VinnieT1/zbook/zbook.step

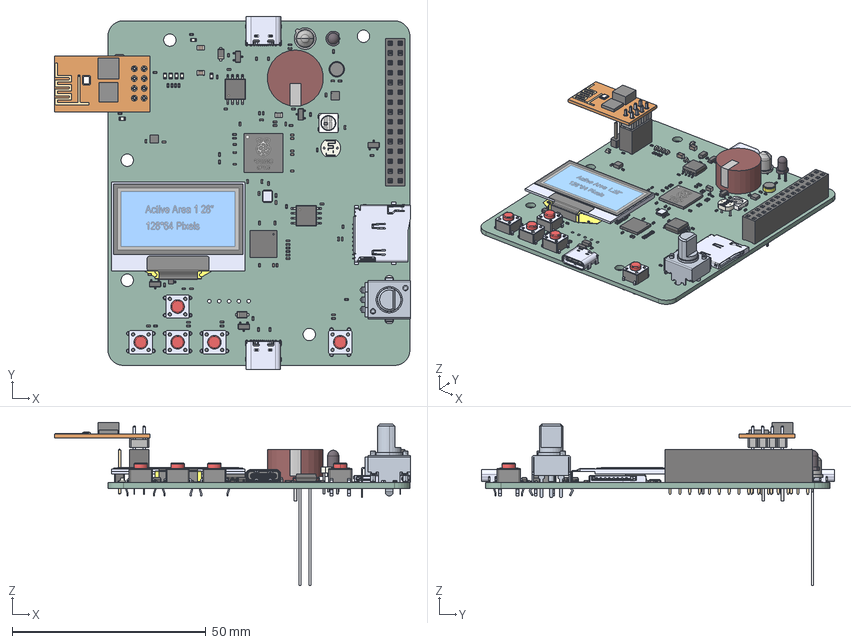
[picture p1: CAD file, 2026-01-20]
zbook.step
92.0 x 91.1 x 42.2 mm
ABM8-272-T3 x 2
R_0402_1005Metric x 46
C_0402_1005Metric x 53
SOT-23 x 6
QFN-56-1EP_7x7mm_P0.4mm_EP3.2x3.2mm
D_SOD-123F x 2
PinSocket_2x04_P2.54mm_Vertical
ESP-01
PS1440P02BT_TDK
SOIC-8_5.3x5.3mm_P1.27mm x 2
FZ2812-5050
LED_0603_1608Metric x 7
ptv09a-4x15f-xxxx
GSDA213
PinHeader_1x05_P2.54mm_Vertical
PinSocket_2x15_P2.54mm_Vertical
OP598A
User Library-RP2350B
C_0805_2012Metric x 2
L_0805_2012Metric
LED_D3.0mm_IRBlack
UJ20-C-H-G-SMT-1-P16-TR_UJ20-C-H-G-SMT-1-P16-TR x 2
DISPLAY_OLED_1.28 v3 v1
R_LDR_5.1x4.3mm_P3.4mm_Vertical
MSD-4-A
LTR-329ALS-01_LTO
Same_Sky_CMEJ-0415-42-P
zbook_PCB
