VinnieT1/zbook/zbook.kicad_pcb

## KiCad design zbook.kicad_pcb (2026-02-26)

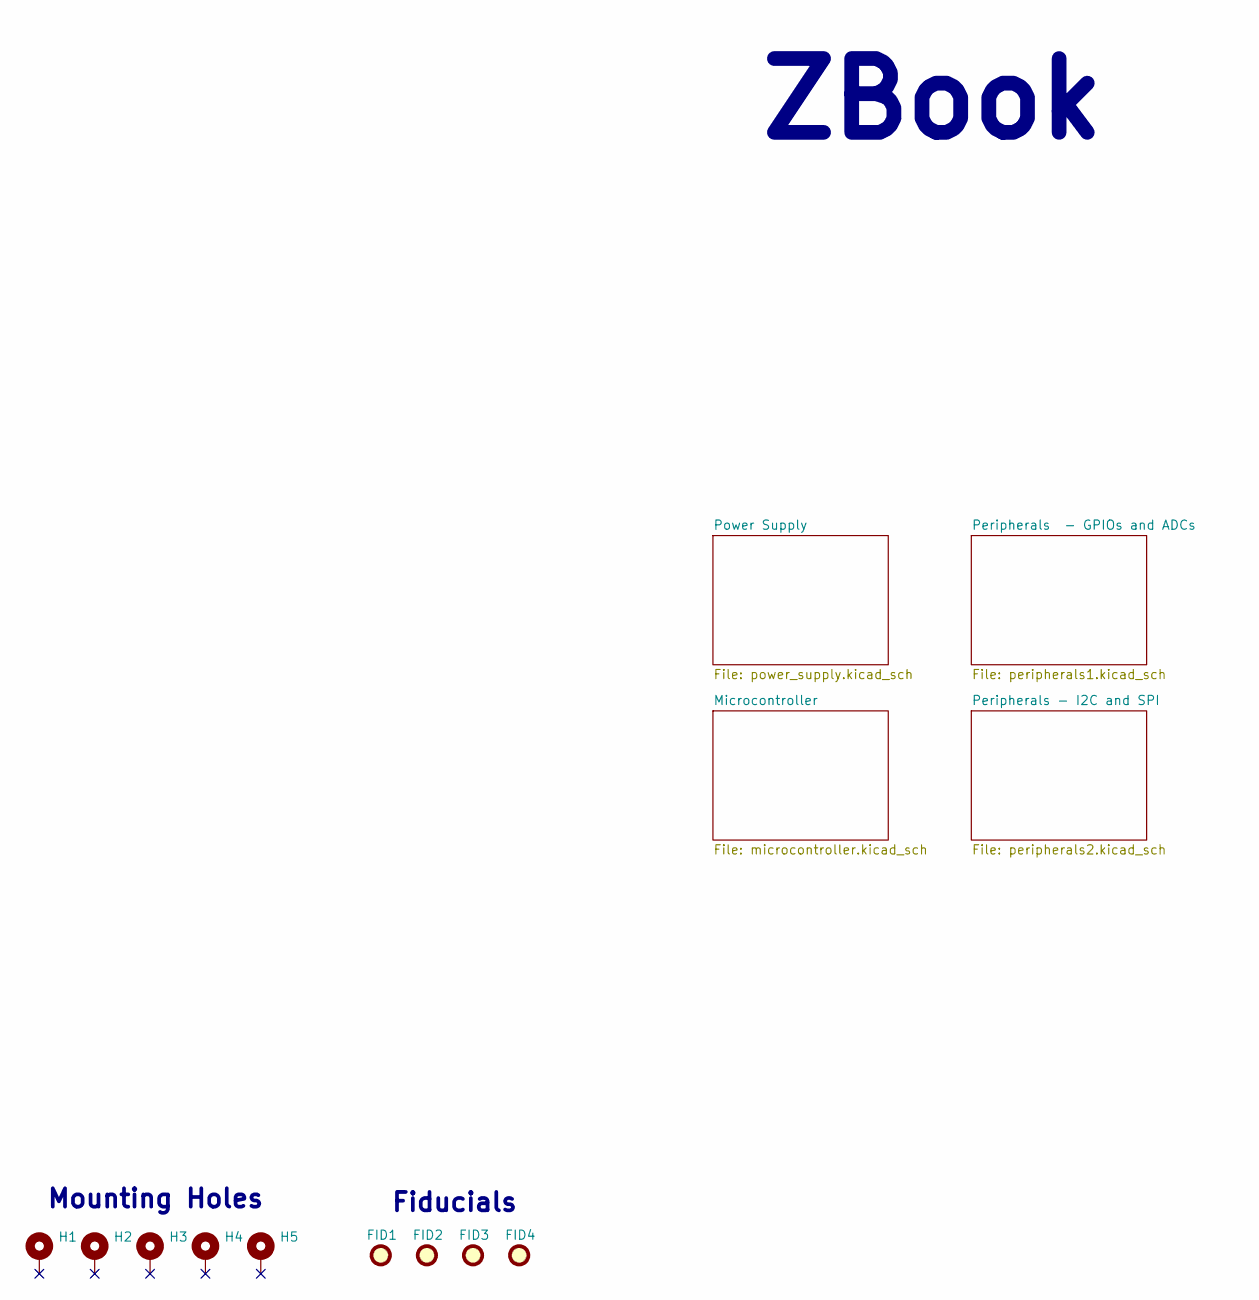
[picture p2: schematic zbook.kicad_sch]

Parts:
FID1, FID2, FID3, FID4: Fiducial; Fiducial_1mm_Mask3mm
H1, H2, H3, H4, H5: MountingHole_Pad; MountingHole_3.2mm_M3

Notes on the sheet:
ZBook
Fiducials
Mounting Holes

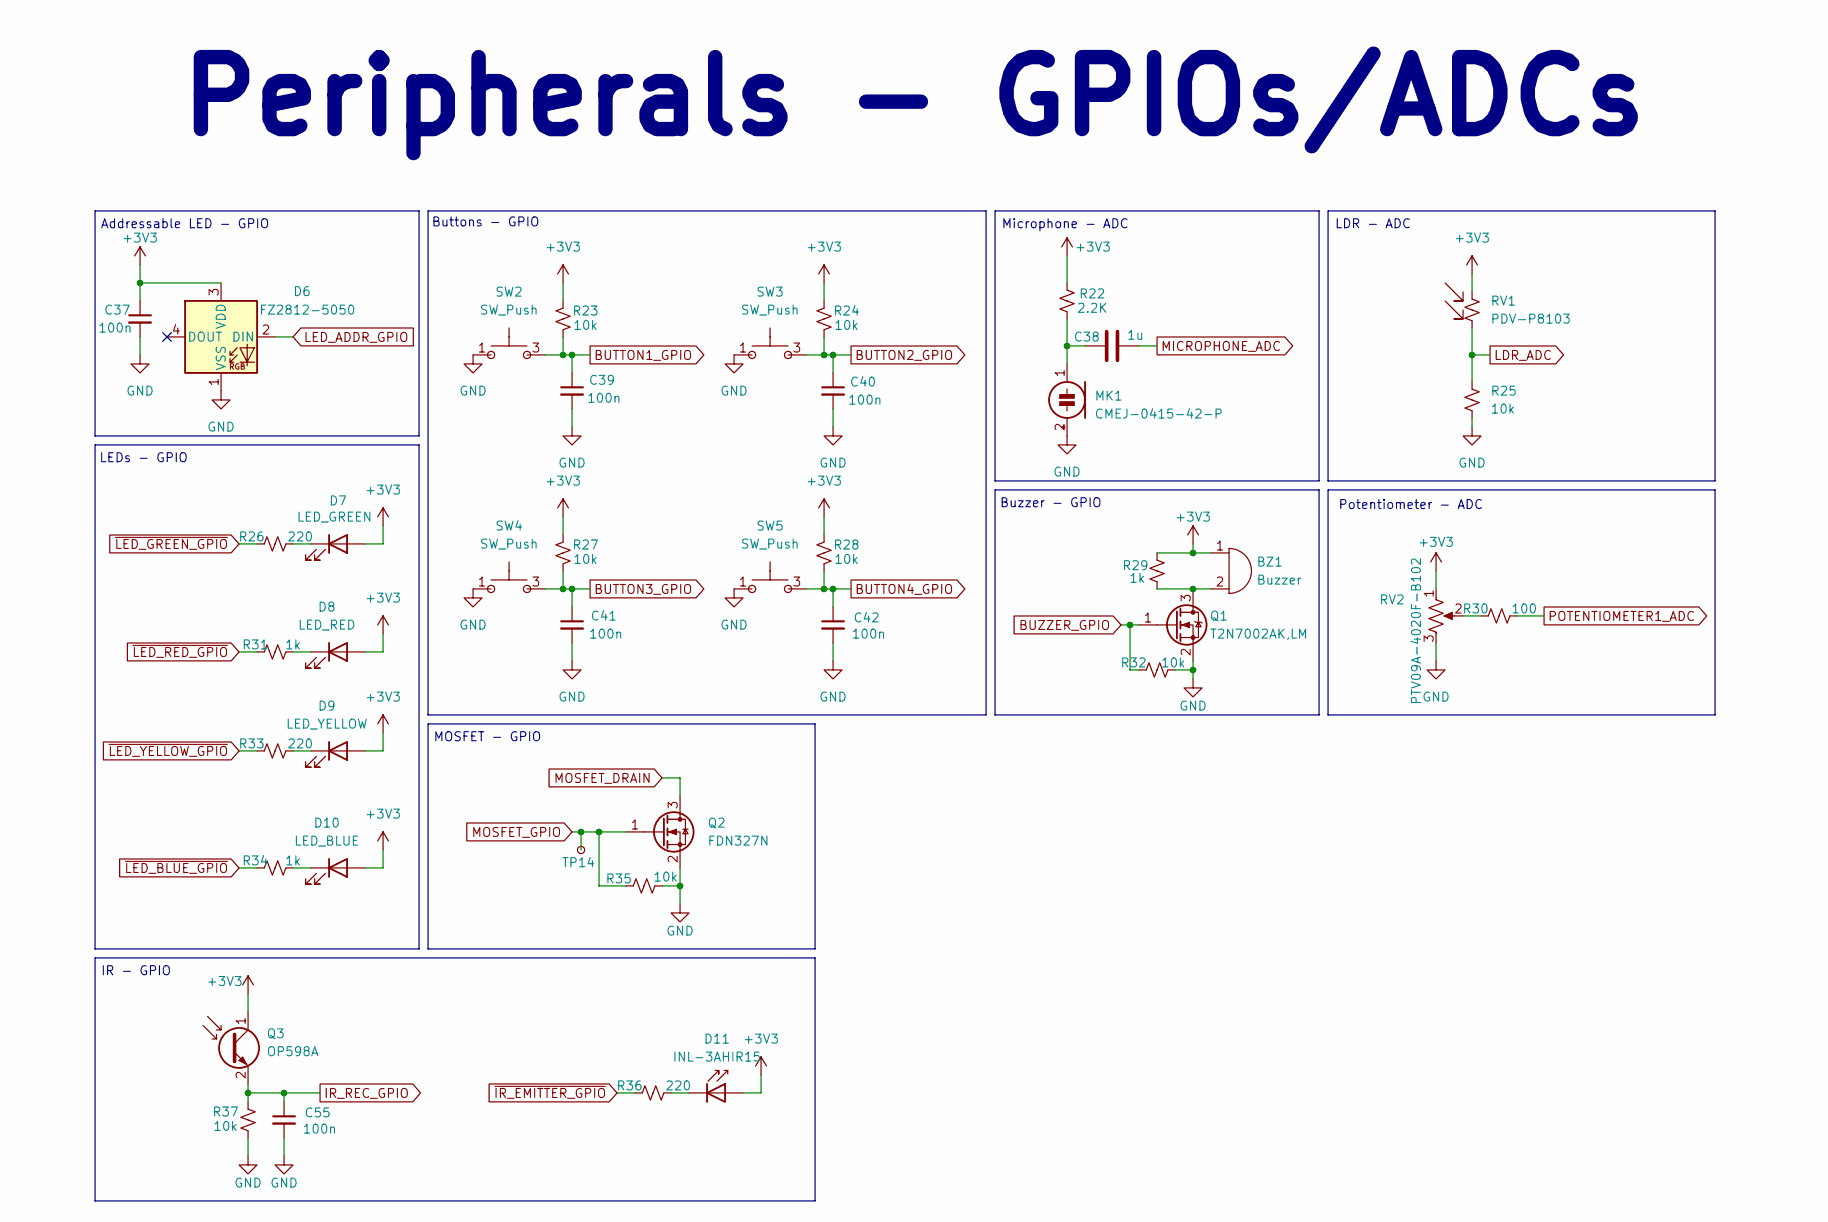
[picture p3: schematic peripherals1.kicad_sch, Peripherals - GPIOs and ADCs]

Parts:
BZ1: Buzzer; PS1440P02BT; MPN PS1440P02BT
C37, C39, C40, C41, C42, C55: 100n; C_0402_1005Metric; MPN CL05B104KA5NNNC
C38: 1u; C_0402_1005Metric; MPN CL05A105KO5NNNC
D6: FZ2812-5050; LED_FZ2812-5050; MPN FZ2812-5050
D7: LED_GREEN; LED_0603_1608Metric; MPN LG Q976.01-MGNI-35-1
D8: LED_RED; LED_0603_1608Metric; MPN QBLP601-R3-2943
D9: LED_YELLOW; LED_0603_1608Metric; MPN LY Q976.01-Q1R2-36-1
D10: LED_BLUE; LED_0603_1608Metric; MPN LB Q99G.01-P1R1-35-1-5-R18
D11: INL-3AHIR15; LED_D3.0mm_IRBlack; MPN INL-3AHIR15
MK1: CMEJ-0415-42-P; CMEJ-0415_CUD; MPN CMEJ-0415-42-P
Q1: T2N7002AK,LM; SOT-23; MPN T2N7002AK,LM
Q2: FDN327N; SOT-23; MPN FDN327N
Q3: OP598A; TO-18-2; MPN OP598A
R22: 2.2K; R_0402_1005Metric; MPN ERA-2AEB222X
R23, R24, R25, R27, R28, R32, R35, R37: 10k; R_0402_1005Metric; MPN RC0402JR-0710KL
R26, R33, R36: 220; R_0402_1005Metric; MPN RC0402JR-13220RL
R29, R31, R34: 1k; R_0402_1005Metric; MPN RC0402JR-071KL
R30: 100; R_0402_1005Metric; MPN ERJ-2RKF1000X
RV1: PDV-P8103; R_LDR_5.1x4.3mm_P3.4mm_Vertical; MPN PDV-P8103
RV2: PTV09A-4020F-B102; MPN PTV09A-4020F-B102
SW2, SW3, SW4, SW5: SW_Push; SW_1825910-6-4; MPN 1825910-6
TP14: TestPoint_Small; TestPoint_Pad_D1.0mm

Connections:
+3V3: BZ1.1 (+), C37.1, D6.3 (VDD), D7.2 (A), D8.2 (A), D9.2 (A), D10.2 (A), D11.2 (A), Q3.1 (C), R22.1, R23.2, R24.2, R27.2, R28.2, R29.2, RV1.1, RV2.1; also elsewhere on the board
BUTTON1_GPIO: C39.1, R23.1, SW2.3; also elsewhere on the board
BUTTON2_GPIO: C40.1, R24.1, SW3.3; also elsewhere on the board
BUTTON3_GPIO: C41.1, R27.1, SW4.3; also elsewhere on the board
BUTTON4_GPIO: C42.1, R28.1, SW5.3; also elsewhere on the board
BUZZER_GPIO: Q1.1 (G), R32.1; also elsewhere on the board
GND: C37.2, C39.2, C40.2, C41.2, C42.2, C55.2, D6.1 (VSS), MK1.2 (+), Q1.2 (S), Q2.2 (S), R25.2, R32.2, R35.2, R37.1, RV2.3, SW2.1, SW3.1, SW4.1, SW5.1; also elsewhere on the board
IR_REC_GPIO: C55.1, Q3.2 (E), R37.2; also elsewhere on the board
LDR_ADC: R25.1, RV1.2; also elsewhere on the board
LED_ADDR_GPIO: D6.2 (DIN); also elsewhere on the board
MICROPHONE_ADC: C38.2; also elsewhere on the board
MOSFET_DRAIN: Q2.3 (D); also elsewhere on the board
MOSFET_GPIO: Q2.1 (G), R35.1, TP14.1; also elsewhere on the board
unnamed: BZ1.2 (-), Q1.3 (D), R29.1
unnamed: D7.1 (K), R26.2
unnamed: D8.1 (K), R31.2
unnamed: D9.1 (K), R33.2
unnamed: D10.1 (K), R34.2
unnamed: D11.1 (K), R36.2
unnamed: C38.1, MK1.1 (-), R22.2
unnamed: R30.1, RV2.2
POTENTIOMETER1_ADC: R30.2; also elsewhere on the board
~IR_EMITTER_GPIO: R36.1; also elsewhere on the board
~LED_BLUE_GPIO: R34.1; also elsewhere on the board
~LED_GREEN_GPIO: R26.1; also elsewhere on the board
~LED_RED_GPIO: R31.1; also elsewhere on the board
~LED_YELLOW_GPIO: R33.1; also elsewhere on the board

Notes on the sheet:
Microphone - ADC
Potentiometer - ADC
LDR - ADC
Buttons - GPIO
Peripherals - GPIOs/ADCs
MOSFET - GPIO
Addressable LED - GPIO
IR - GPIO
LEDs - GPIO
Buzzer - GPIO

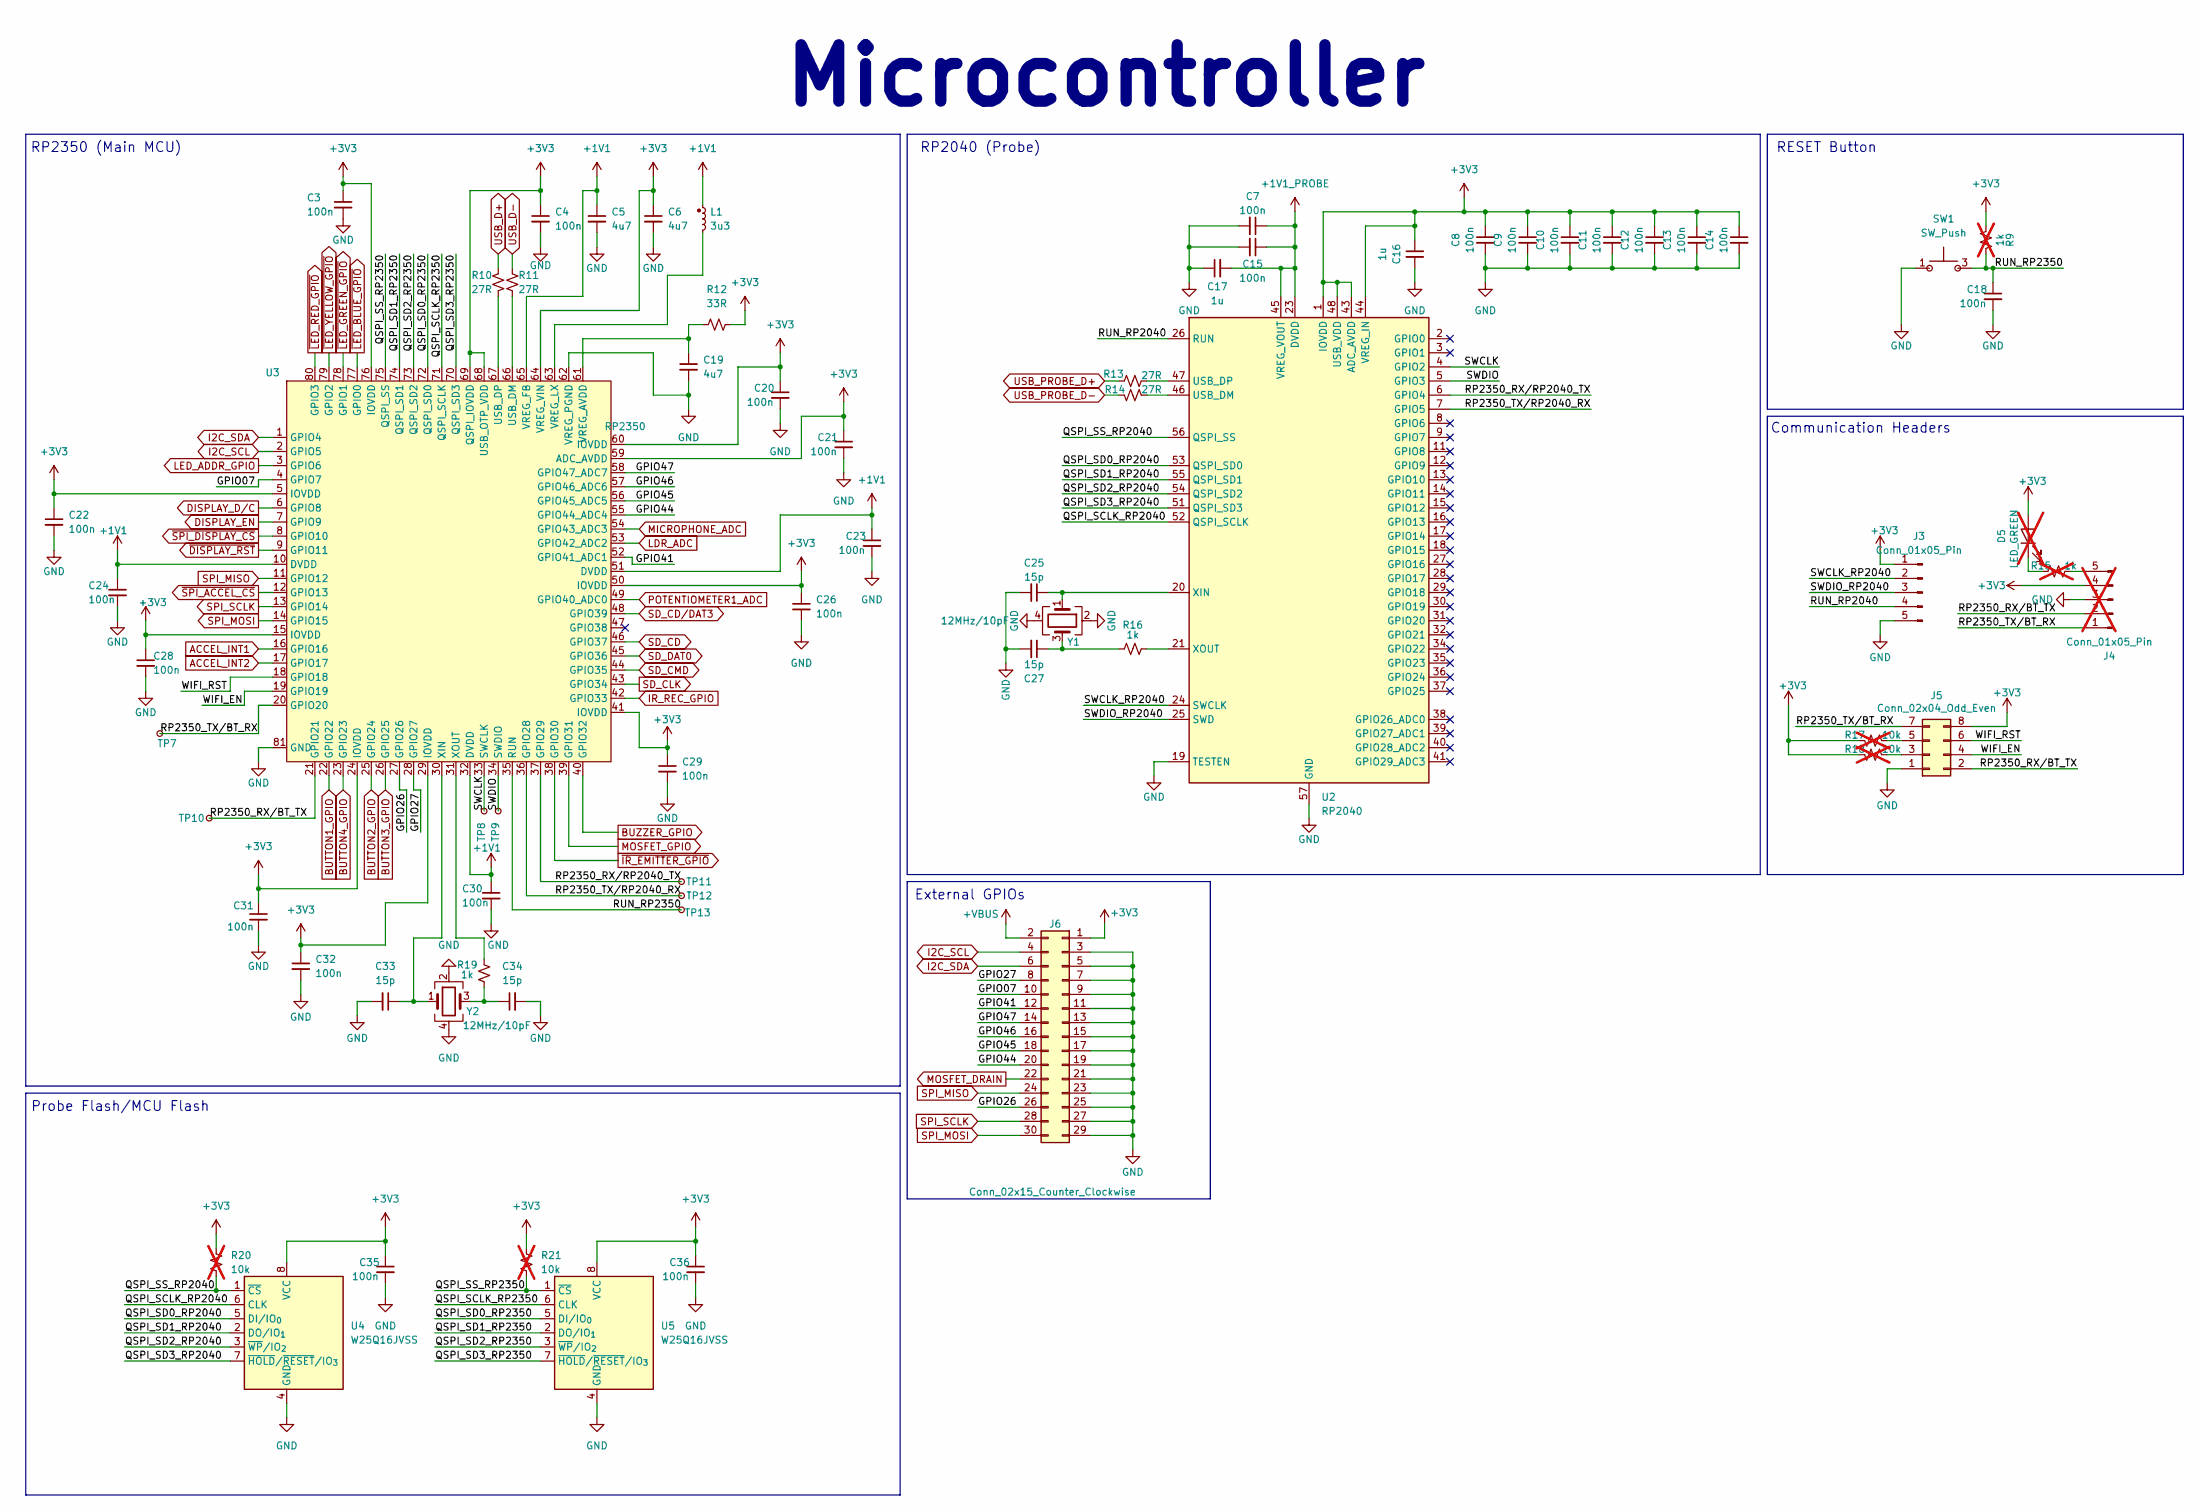
[picture p4: schematic microcontroller.kicad_sch]

Parts:
C3, C4, C7, C8, C9, C10, C11, C12, C13, C14, C15, C18, C20, C21, C22, C23, C24, C26, C28, C29, C30, C31, C32, C35, C36: 100n; C_0402_1005Metric; MPN CL05B104KA5NNNC
C5, C6, C19: 4u7; C_0402_1005Metric; MPN CL05A475MP5NRNC
C16, C17: 1u; C_0402_1005Metric; MPN CL05A105KO5NNNC
C25, C27, C33, C34: 15p; C_0402_1005Metric; MPN GCM1555C1H150JA16D
D5: LED_GREEN; LED_0603_1608Metric; MPN LG Q976.01-MGNI-35-1; not fitted
J3: Conn_01x05_Pin; PogoPins
J4: Conn_01x05_Pin; PinHeader_1x05_P2.54mm_Vertical; MPN PH1-05-UA; not fitted
J5: Conn_02x04_Odd_Even; PinSocket_2x04_P2.54mm_Vertical; MPN 61300821821
J6: Conn_02x15_Counter_Clockwise; PinSocket_2x15_P2.54mm_Vertical; MPN PPPC152LFBN-RC
L1: 3u3; L_0805_2012Metric_Pad1.15x1.40mm_HandSolder; MPN AOTA-B201610S3R3-101-T
R9, R15: 1k; R_0402_1005Metric; MPN RC0402JR-071KL; not fitted
R10, R11, R13, R14: 27R; R_0402_1005Metric; MPN RC0402JR-0727RL
R12: 33R; R_0402_1005Metric; MPN RC0402JR-0733RL
R16, R19: 1k; R_0402_1005Metric; MPN RC0402JR-071KL
R17, R18, R20, R21: 10k; R_0402_1005Metric; MPN RC0402JR-0710KL; not fitted
SW1: SW_Push; SW_1825910-6-4; MPN 1825910-6
TP7, TP8, TP9, TP10, TP11, TP12, TP13: TestPoint_Small; TestPoint_Pad_D1.0mm
U2: RP2040; QFN-56-1EP_7x7mm_P0.4mm_EP3.2x3.2mm_ThermalVias; MPN SC0914(13)
U3: RP2350; QFN-80_EP_14x14_Pitch0.4mm; MPN SC1510
U4, U5: W25Q16JVSS; SOIC-8_5.3x5.3mm_P1.27mm; MPN W25Q16JVSSIQ
Y1, Y2: 12MHz/10pF; XTAL_ABM8-272-T3; MPN ABM8-272-T3

Connections:
+1V1: C5.1, C23.1, C24.1, C30.1, L1.1, U3.10 (DVDD), U3.32 (DVDD), U3.51 (DVDD), U3.65 (VREG_FB)
+1V1_PROBE: C7.1, C15.1, C17.2, U2.23 (DVDD), U2.45 (VREG_VOUT), U2.50 (DVDD)
+3V3: C3.1, C4.1, C6.1, C8.1, C9.1, C10.1, C11.1, C12.1, C13.1, C14.1, C16.1, C20.1, C21.1, C22.1, C26.1, C28.1, C29.1, C31.1, C32.1, C35.1, C36.1, D5.2 (A), J3.1, J4.4, J5.8, J6.1, R9.2, R12.2, R17.2, R18.2, R20.1, R21.1, U2.1 (IOVDD), U2.10 (IOVDD), U2.22 (IOVDD), U2.33 (IOVDD), U2.42 (IOVDD), U2.43 (ADC_AVDD), U2.44 (VREG_IN), U2.48 (USB_VDD), U2.49 (IOVDD), U3.5 (IOVDD), U3.15 (IOVDD), U3.24 (IOVDD), U3.29 (IOVDD), U3.41 (IOVDD), U3.50 (IOVDD), U3.59 (ADC_AVDD), U3.60 (IOVDD), U3.64 (VREG_VIN), U3.68 (USB_OTP_VDD), U3.69 (QSPI_IOVDD), U3.76 (IOVDD), U4.8 (VCC), U5.8 (VCC); also elsewhere on the board
+VBUS: J6.2; also elsewhere on the board
/Microcontroller/GPIO07: J6.10, U3.4 (GPIO7)
/Microcontroller/GPIO26: J6.26, U3.27 (GPIO26)
/Microcontroller/GPIO27: J6.8, U3.28 (GPIO27)
/Microcontroller/GPIO41: J6.12, U3.52 (GPIO41_ADC1)
/Microcontroller/GPIO44: J6.20, U3.55 (GPIO44_ADC4)
/Microcontroller/GPIO45: J6.18, U3.56 (GPIO45_ADC5)
/Microcontroller/GPIO46: J6.16, U3.57 (GPIO46_ADC6)
/Microcontroller/GPIO47: J6.14, U3.58 (GPIO47_ADC7)
/Microcontroller/QSPI_SCLK_RP2040: U2.52 (QSPI_SCLK), U4.6 (CLK)
/Microcontroller/QSPI_SCLK_RP2350: U3.71 (QSPI_SCLK), U5.6 (CLK)
/Microcontroller/QSPI_SD0_RP2040: U2.53 (QSPI_SD0), U4.5 (DI/IO_{0})
/Microcontroller/QSPI_SD0_RP2350: U3.72 (QSPI_SD0), U5.5 (DI/IO_{0})
/Microcontroller/QSPI_SD1_RP2040: U2.55 (QSPI_SD1), U4.2 (DO/IO_{1})
/Microcontroller/QSPI_SD1_RP2350: U3.74 (QSPI_SD1), U5.2 (DO/IO_{1})
/Microcontroller/QSPI_SD2_RP2040: U2.54 (QSPI_SD2), U4.3 (~WP/IO_{2})
/Microcontroller/QSPI_SD2_RP2350: U3.73 (QSPI_SD2), U5.3 (~WP/IO_{2})
/Microcontroller/QSPI_SD3_RP2040: U2.51 (QSPI_SD3), U4.7 (~HOLD/~RESET/IO_{3})
/Microcontroller/QSPI_SD3_RP2350: U3.70 (QSPI_SD3), U5.7 (~HOLD/~RESET/IO_{3})
/Microcontroller/QSPI_SS_RP2040: R20.2, U2.56 (QSPI_SS), U4.1 (~CS)
/Microcontroller/QSPI_SS_RP2350: R21.2, U3.75 (QSPI_SS), U5.1 (~CS)
/Microcontroller/RP2350_RX/BT_TX: J4.2, J5.2, TP10.1, U3.21 (GPIO21)
/Microcontroller/RP2350_RX/RP2040_TX: TP11.1, U2.6 (GPIO4), U3.37 (GPIO29)
/Microcontroller/RP2350_TX/BT_RX: J4.1, J5.7, TP7.1, U3.20 (GPIO20)
/Microcontroller/RP2350_TX/RP2040_RX: TP12.1, U2.7 (GPIO5), U3.36 (GPIO28)
/Microcontroller/RUN_RP2040: J3.4, U2.26 (RUN)
/Microcontroller/RUN_RP2350: C18.1, R9.1, SW1.3, TP13.1, U3.35 (RUN)
/Microcontroller/SWCLK: TP8.1, U2.4 (GPIO2), U3.33 (SWCLK)
/Microcontroller/SWCLK_RP2040: J3.2, U2.24 (SWCLK)
/Microcontroller/SWDIO: TP9.1, U2.5 (GPIO3), U3.34 (SWDIO)
/Microcontroller/SWDIO_RP2040: J3.3, U2.25 (SWD)
/Microcontroller/WIFI_EN: J5.4, U3.19 (GPIO19)
/Microcontroller/WIFI_RST: J5.6, U3.18 (GPIO18)
ACCEL_INT1: U3.16 (GPIO16); also elsewhere on the board
ACCEL_INT2: U3.17 (GPIO17); also elsewhere on the board
BUTTON1_GPIO: U3.22 (GPIO22); also elsewhere on the board
BUTTON2_GPIO: U3.25 (GPIO24); also elsewhere on the board
BUTTON3_GPIO: U3.26 (GPIO25); also elsewhere on the board
BUTTON4_GPIO: U3.23 (GPIO23); also elsewhere on the board
BUZZER_GPIO: U3.40 (GPIO32); also elsewhere on the board
DISPLAY_D/C: U3.6 (GPIO8); also elsewhere on the board
DISPLAY_EN: U3.7 (GPIO9); also elsewhere on the board
GND: C3.2, C4.2, C5.2, C6.2, C7.2, C8.2, C9.2, C10.2, C11.2, C12.2, C13.2, C14.2, C15.2, C16.2, C17.1, C18.2, C19.2, C20.2, C21.2, C22.2, C23.2, C24.2, C25.2, C26.2, C27.2, C28.2, C29.2, C30.2, C31.2, C32.2, C33.2, C34.2, C35.2, C36.2, J3.5, J4.3, J5.1, J6.3, J6.5, J6.7, J6.9, J6.11, J6.13, J6.15, J6.17, J6.19, J6.21, J6.23, J6.25, J6.27, J6.29, SW1.1, U2.19 (TESTEN), U2.57 (GND), U3.62 (VREG_PGND), U3.81 (GND), U4.4 (GND), U5.4 (GND), Y1.2, Y1.4, Y2.2, Y2.4; also elsewhere on the board
I2C_SCL: J6.4, U3.2 (GPIO5); also elsewhere on the board
I2C_SDA: J6.6, U3.1 (GPIO4); also elsewhere on the board
IR_REC_GPIO: U3.42 (GPIO33); also elsewhere on the board
LDR_ADC: U3.53 (GPIO42_ADC2); also elsewhere on the board
LED_ADDR_GPIO: U3.3 (GPIO6); also elsewhere on the board
MICROPHONE_ADC: U3.54 (GPIO43_ADC3); also elsewhere on the board
MOSFET_DRAIN: J6.22; also elsewhere on the board
MOSFET_GPIO: U3.39 (GPIO31); also elsewhere on the board
unnamed: C27.1, R16.1, Y1.3
unnamed: C34.1, R19.1, Y2.3
unnamed: D5.1 (K), R15.1
unnamed: J4.5, R15.2
unnamed: J5.3, R18.1
unnamed: J5.5, R17.1
unnamed: R14.2, U2.46 (USB_DM)
unnamed: R13.2, U2.47 (USB_DP)
unnamed: C25.1, U2.20 (XIN), Y1.1
unnamed: R16.2, U2.21 (XOUT)
unnamed: R11.2, U3.66 (USB_DM)
unnamed: R10.2, U3.67 (USB_DP)
unnamed: C19.1, R12.1, U3.61 (VREG_AVDD)
unnamed: L1.2, U3.63 (VREG_LX)
unnamed: C33.1, U3.30 (XIN), Y2.1
unnamed: R19.2, U3.31 (XOUT)
POTENTIOMETER1_ADC: U3.49 (GPIO40_ADC0); also elsewhere on the board
SD_CD: U3.46 (GPIO37); also elsewhere on the board
SD_CD/DAT3: U3.48 (GPIO39); also elsewhere on the board
SD_CLK: U3.43 (GPIO34); also elsewhere on the board
SD_CMD: U3.44 (GPIO35); also elsewhere on the board
SD_DAT0: U3.45 (GPIO36); also elsewhere on the board
SPI_MISO: J6.24, U3.11 (GPIO12); also elsewhere on the board
SPI_MOSI: J6.30, U3.14 (GPIO15); also elsewhere on the board
SPI_SCLK: J6.28, U3.13 (GPIO14); also elsewhere on the board
USB_D+: R10.1; also elsewhere on the board
USB_D-: R11.1; also elsewhere on the board
USB_PROBE_D+: R13.1; also elsewhere on the board
USB_PROBE_D-: R14.1; also elsewhere on the board
~DISPLAY_RST: U3.9 (GPIO11); also elsewhere on the board
~IR_EMITTER_GPIO: U3.38 (GPIO30); also elsewhere on the board
~LED_BLUE_GPIO: U3.77 (GPIO0); also elsewhere on the board
~LED_GREEN_GPIO: U3.78 (GPIO1); also elsewhere on the board
~LED_RED_GPIO: U3.80 (GPIO3); also elsewhere on the board
~LED_YELLOW_GPIO: U3.79 (GPIO2); also elsewhere on the board
~SPI_ACCEL_CS: U3.12 (GPIO13); also elsewhere on the board
~SPI_DISPLAY_CS: U3.8 (GPIO10); also elsewhere on the board

Notes on the sheet:
Microcontroller
RP2350 (Main MCU)
Communication Headers
RESET Button
RP2040 (Probe)
External GPIOs
Probe Flash/MCU Flash

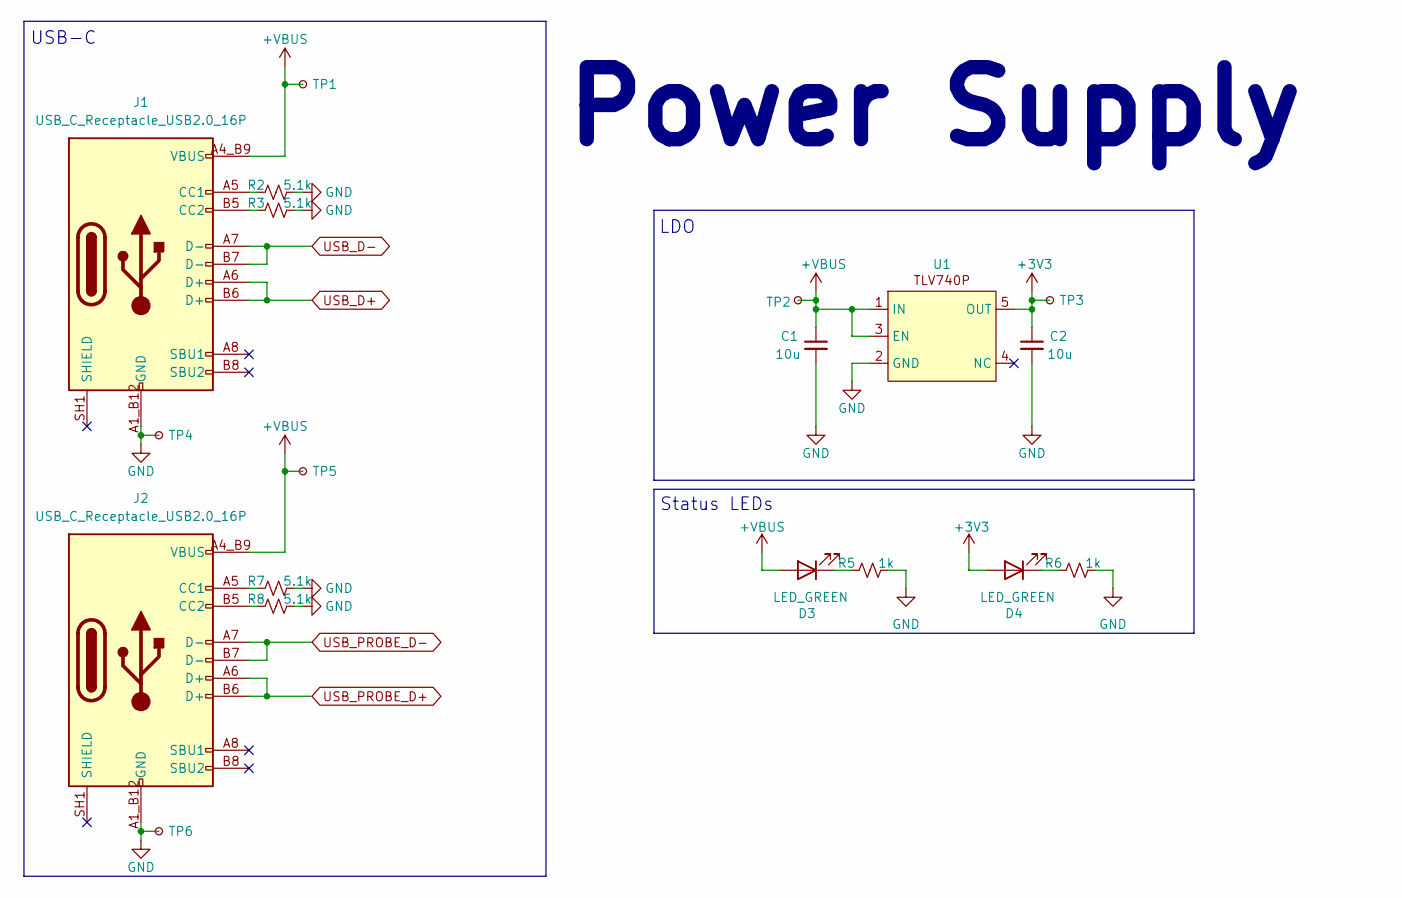
[picture p5: schematic power_supply.kicad_sch, Power Supply]

Parts:
C1, C2: 10u; C_0805_2012Metric; MPN CL21A106KOQNNNG
D3, D4: LED_GREEN; LED_0603_1608Metric; MPN LG Q976.01-MGNI-35-1
J1, J2: USB_C_Receptacle_USB2.0_16P; SAMESKY_UJ20-C-H-G-SMT-1-P16-TR; MPN UJ20-C-H-G-SMT-1-P16-TR
R2, R3, R7, R8: 5.1k; R_0402_1005Metric; MPN AC0402FR-075K1L
R5, R6: 1k; R_0402_1005Metric; MPN RC0402JR-071KL
TP1, TP2, TP3, TP4, TP5, TP6: TestPoint_Small; TestPoint_Pad_D1.0mm
U1: TLV78533PDBVR; DBV0005A-IPC_B; MPN TLV78533PDBVR

Connections:
+3V3: C2.1, D4.2 (A), TP3.1, U1.5 (OUT); also elsewhere on the board
+VBUS: C1.1, D3.2 (A), J1.A4_B9 (VBUS), J1.B4_A9 (VBUS), J2.A4_B9 (VBUS), J2.B4_A9 (VBUS), TP1.1, TP2.1, TP5.1, U1.1 (IN), U1.3 (EN); also elsewhere on the board
GND: C1.2, C2.2, J1.A1_B12 (GND), J1.B1_A12 (GND), J2.A1_B12 (GND), J2.B1_A12 (GND), R2.2, R3.2, R5.1, R6.1, R7.2, R8.2, TP4.1, TP6.1, U1.2 (GND); also elsewhere on the board
unnamed: D3.1 (K), R5.2
unnamed: D4.1 (K), R6.2
unnamed: J1.A5 (CC1), R2.1
unnamed: J1.B5 (CC2), R3.1
unnamed: J2.A5 (CC1), R7.1
unnamed: J2.B5 (CC2), R8.1
USB_D+: J1.A6 (D+), J1.B6 (D+); also elsewhere on the board
USB_D-: J1.A7 (D-), J1.B7 (D-); also elsewhere on the board
USB_PROBE_D+: J2.A6 (D+), J2.B6 (D+); also elsewhere on the board
USB_PROBE_D-: J2.A7 (D-), J2.B7 (D-); also elsewhere on the board

Notes on the sheet:
Status LEDs
USB-C
Power Supply
LDO

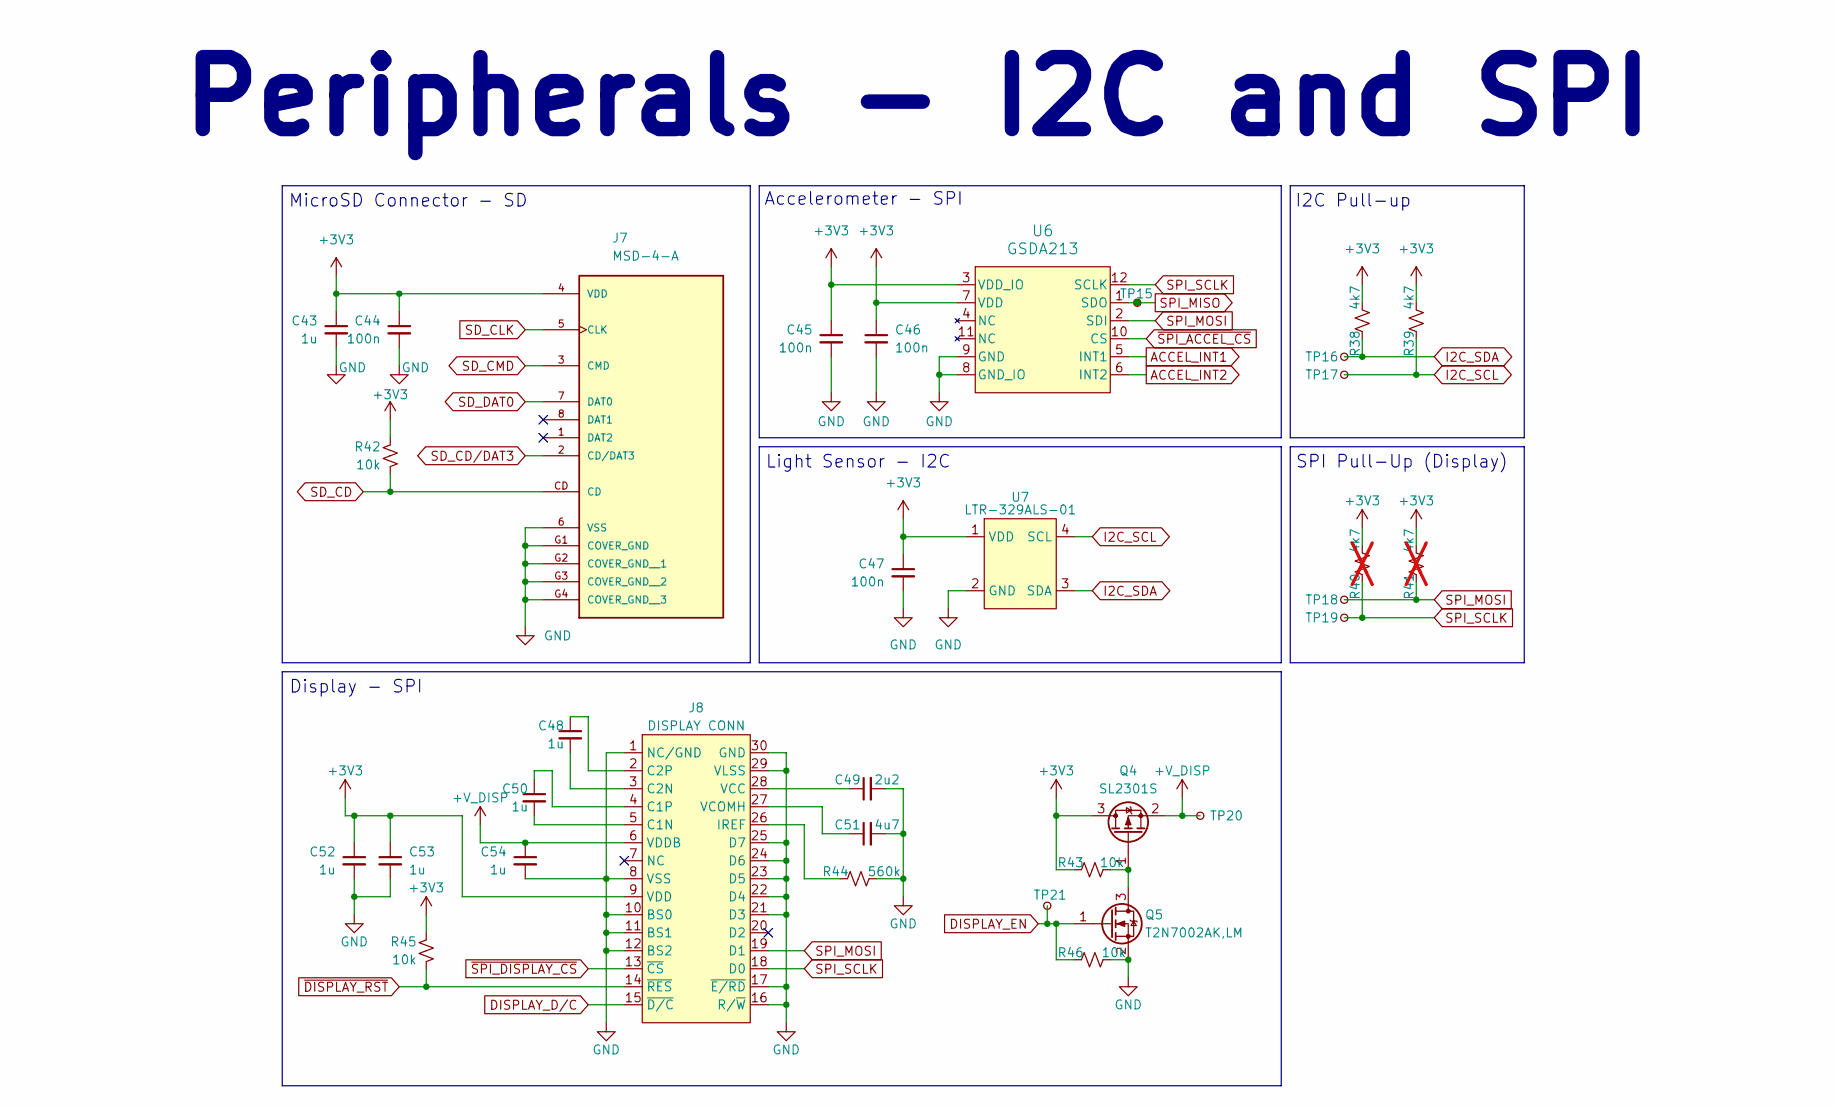
[picture p6: schematic peripherals2.kicad_sch, Peripherals - I2C and SPI]

Parts:
C43, C48, C50, C52, C53, C54: 1u; C_0402_1005Metric; MPN CL05A105KO5NNNC
C44, C45, C46, C47: 100n; C_0402_1005Metric; MPN CL05B104KA5NNNC
C49: 2u2; C_0402_1005Metric; MPN CL05A225KO5NQNC
C51: 4u7; C_0402_1005Metric; MPN CL05A475MP5NRNC
J7: MSD-4-A; CUI_MSD-4-A; PARTREV 1.0
J8: DISPLAY CONN; FPC_30
Q4: SL2301S; SOT-23; MPN SL2301S
Q5: T2N7002AK,LM; SOT-23; MPN T2N7002AK,LM
R38, R39: 4k7; R_0402_1005Metric; MPN RC0402JR-074K7L
R40, R41: 4k7; R_0402_1005Metric; MPN RC0402JR-074K7L; not fitted
R42, R43, R45, R46: 10k; R_0402_1005Metric; MPN RC0402JR-0710KL
R44: 560k; R_0402_1005Metric; MPN RC0402JR-07560KL
TP15, TP16, TP17, TP18, TP19, TP20, TP21: TestPoint_Small; TestPoint_Pad_D1.0mm
U6: GSDA213; LGA12_GAS-M; MPN GSDA213
U7: LTR-329ALS-01; LTR-329ALS-01_LTO-M; MPN LTR-329ALS-01

Connections:
+3V3: C43.1, C44.1, C45.1, C46.1, C47.1, C52.1, C53.1, J7.4 (VDD), J8.9 (VDD), Q4.3 (D), R38.2, R39.2, R40.2, R41.2, R42.1, R43.1, R45.1, U6.3 (VDD_IO), U6.7 (VDD), U7.1 (VDD); also elsewhere on the board
+V_DISP: C54.1, J8.6 (VDDB), Q4.2 (S), TP20.1
ACCEL_INT1: U6.5 (INT1); also elsewhere on the board
ACCEL_INT2: U6.6 (INT2); also elsewhere on the board
DISPLAY_D/C: J8.15 (~D/C); also elsewhere on the board
DISPLAY_EN: Q5.1 (G), R46.1, TP21.1; also elsewhere on the board
GND: C43.2, C44.2, C45.2, C46.2, C47.2, C49.2, C51.2, C52.2, C53.2, C54.2, J7.6 (VSS), J7.G1 (COVER_GND), J7.G2 (COVER_GND__1), J7.G3 (COVER_GND__2), J7.G4 (COVER_GND__3), J8.1 (NC/GND), J8.8 (VSS), J8.10 (BS0), J8.11 (BS1), J8.12 (BS2), J8.16 (R/~W), J8.17 (~E/RD), J8.21 (D3), J8.22 (D4), J8.23 (D5), J8.24 (D6), J8.25 (D7), J8.29 (VLSS), J8.30 (GND), Q5.2 (S), R44.2, R46.2, U6.8 (GND_IO), U6.9 (GND), U7.2 (GND); also elsewhere on the board
I2C_SCL: R39.1, TP17.1, U7.4 (SCL); also elsewhere on the board
I2C_SDA: R38.1, TP16.1, U7.3 (SDA); also elsewhere on the board
unnamed: C50.2, J8.5 (C1N)
unnamed: C50.1, J8.4 (C1P)
unnamed: C48.2, J8.3 (C2N)
unnamed: C48.1, J8.2 (C2P)
unnamed: J8.26 (IREF), R44.1
unnamed: C49.1, J8.28 (VCC)
unnamed: C51.1, J8.27 (VCOMH)
unnamed: Q4.1 (G), Q5.3 (D), R43.2
SD_CD: J7.CD, R42.2; also elsewhere on the board
SD_CD/DAT3: J7.2 (CD/DAT3); also elsewhere on the board
SD_CLK: J7.5 (CLK); also elsewhere on the board
SD_CMD: J7.3 (CMD); also elsewhere on the board
SD_DAT0: J7.7 (DAT0); also elsewhere on the board
SPI_MISO: TP15.1, U6.1 (SDO); also elsewhere on the board
SPI_MOSI: J8.19 (D1), R41.1, TP18.1, U6.2 (SDI); also elsewhere on the board
SPI_SCLK: J8.18 (D0), R40.1, TP19.1, U6.12 (SCLK); also elsewhere on the board
~DISPLAY_RST: J8.14 (~RES), R45.2; also elsewhere on the board
~SPI_ACCEL_CS: U6.10 (CS); also elsewhere on the board
~SPI_DISPLAY_CS: J8.13 (~CS); also elsewhere on the board

Notes on the sheet:
Light Sensor - I2C
MicroSD Connector - SD
I2C Pull-up
Accelerometer - SPI
SPI Pull-Up (Display)
Peripherals - I2C and SPI
Display - SPI

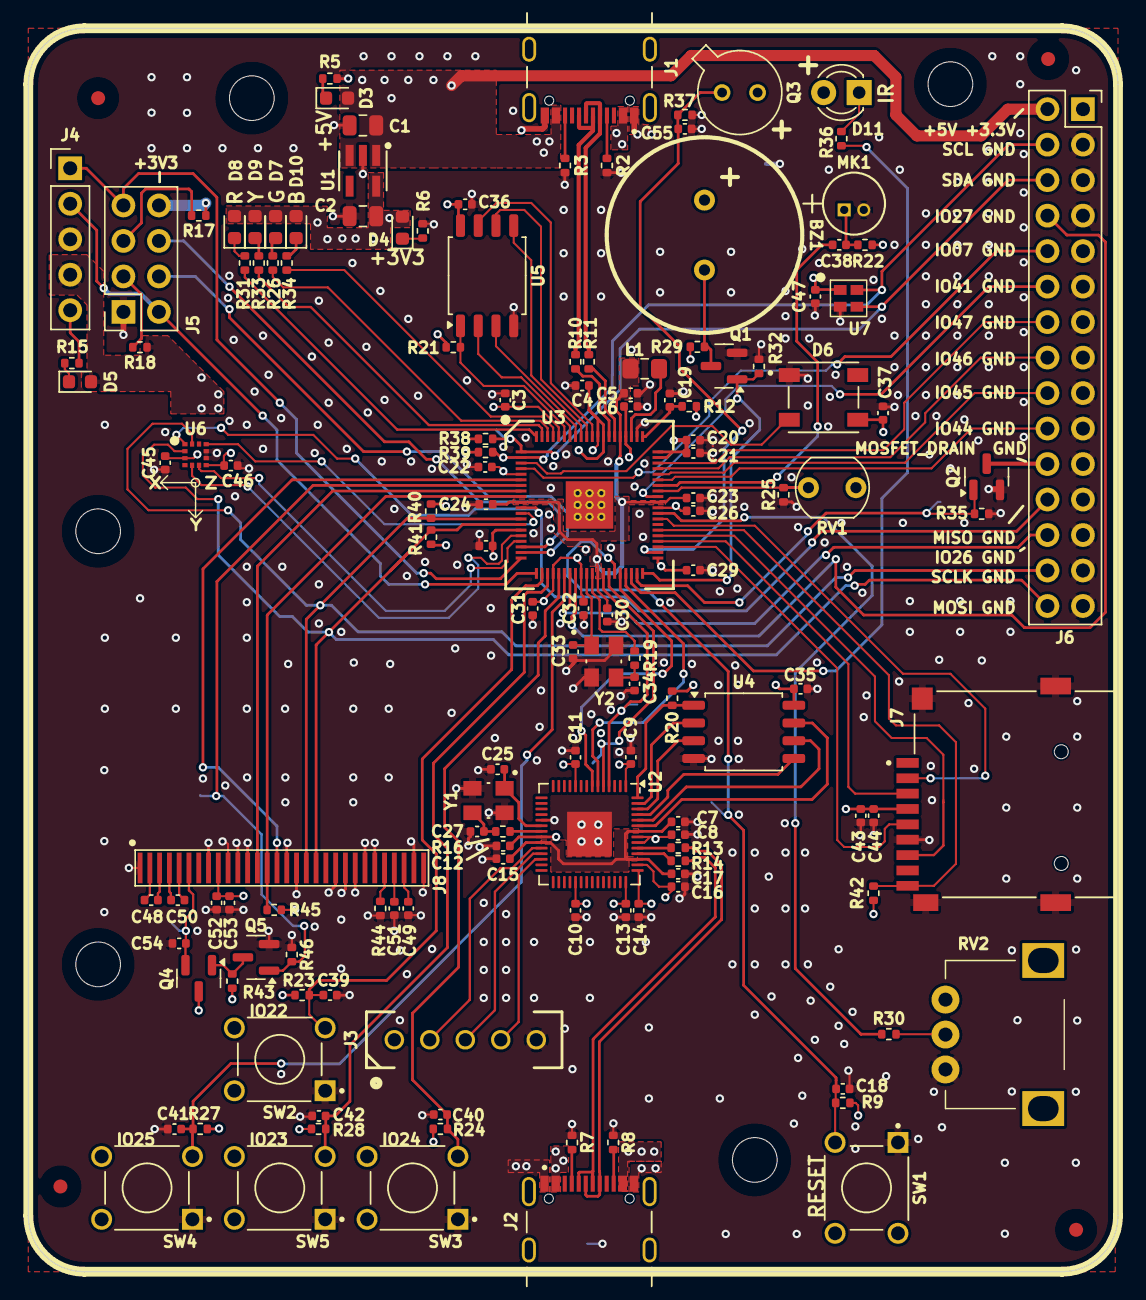
[picture p7: board zbook.kicad_pcb from above]

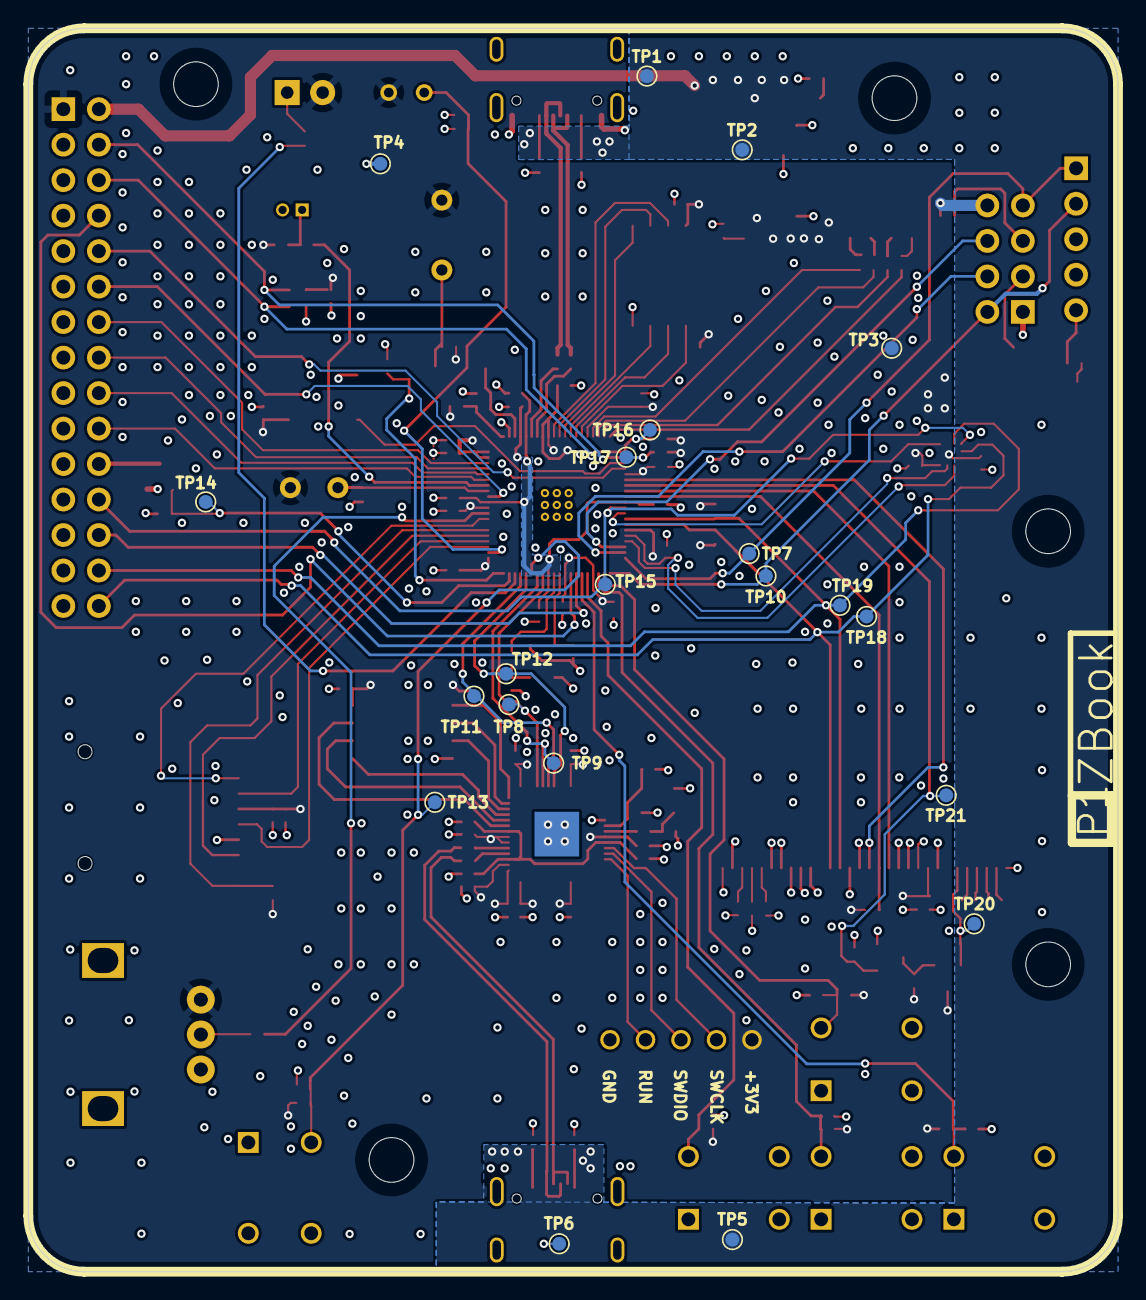
[picture p8: board zbook.kicad_pcb from below]

Board: 4 copper layers, 78.0 x 89.0 mm, 170 parts (21 on the bottom side), 114 nets.
