VinnieT1/zbook/(commit log)

2025-06-19 chore: initial commit
    [main.kicad_sch, microcontroller.kicad_sch, peripherals.kicad_sch, untitled.kicad_sch, zbook.kicad_pcb, zbook.kicad_sch]
2025-06-19 chore: adds new sheet and removes .lck
    [microcontroller.kicad_sch, peripherals1.kicad_sch, peripherals2.kicad_sch, zbook.kicad_sch]
2025-06-19 feat: started power supply and created lib folder
    [main.kicad_sch]
2025-06-20 feat: adds symbols for RP2350 and external flash
    [microcontroller.kicad_sch]
2025-06-20 Feat: added more things to the power supply
    [main.kicad_sch]
2025-06-20 feat: adds probe circuitry (RP2040)
    [microcontroller.kicad_sch]
2025-06-22 feat: adds reset buttons and probe connection
    [microcontroller.kicad_sch]
2025-06-22 feat: add components to peripherals1
    [peripherals1.kicad_sch]
2025-06-22 refac: changes LED direction, mic output and potentiometer
    [peripherals1.kicad_sch]
2025-06-22 feat:adds technical informations to components
    [peripherals1.kicad_sch]
2025-06-22 feat: adds the peripherals-2 to project
    [peripherals2.kicad_sch]
2025-06-23 feat: added MPN to resistors, changed USB_C receptacle
    [main.kicad_sch]
2025-06-23 refac: changed USB_D+ and USB_D-
    [main.kicad_sch]
2025-06-23 refac: adjusts circuits for MicroSD, Accelerometer, Light Sensor
    [peripherals2.kicad_sch]
2025-06-23 fix: adds footprint to capacitors
    [peripherals2.kicad_sch]
2025-06-23 fix: corrects accelerometer designator
    [peripherals2.kicad_sch]
2025-06-23 refac: changes resistor symbol to US pattern, adds second USB-C connector
    [power_supply.kicad_sch, zbook.kicad_sch]
2025-06-23 chore: adds bg color to RP2350 symbol
    [microcontroller.kicad_sch]
2025-06-23 refac: reannotates designators
    [microcontroller.kicad_sch, peripherals1.kicad_sch, peripherals2.kicad_sch, power_supply.kicad_sch]
2025-06-23 chore: links global labels
    [microcontroller.kicad_sch, peripherals1.kicad_sch, peripherals2.kicad_sch]
2025-06-23 chore: adds titles to sheets and organizes root
    [microcontroller.kicad_sch, peripherals1.kicad_sch, peripherals2.kicad_sch, power_supply.kicad_sch, zbook.kicad_sch]
2025-06-23 refac: standardizes schematic sectorization
    [microcontroller.kicad_sch, peripherals1.kicad_sch, peripherals2.kicad_sch, power_supply.kicad_sch]
2025-06-23 feat: adds Vreg circuitry
    [microcontroller.kicad_sch]
2025-06-23 feat: adds 0R for BQ bypass
    [power_supply.kicad_sch]
2025-06-23 refac: unfits battery circuitry
    [power_supply.kicad_sch]
2025-06-23 refac: removes COVER_GND from GND
    [peripherals2.kicad_sch]
2025-06-23 feat: adds IR components
    [peripherals1.kicad_sch]
2025-06-24 feat: adds footprints to Microcontroller sheet circuits
    [microcontroller.kicad_sch]
2025-06-24 refac: moves circuits around
    [peripherals1.kicad_sch]
2025-06-24 feat: adds footprints to Peripherals1 sheet components
    [peripherals1.kicad_sch]
2025-06-25 refac: changes LED MPN and unfits them
    [power_supply.kicad_sch]
2025-06-25 feat: adds directions to global labels
    [peripherals2.kicad_sch]
2025-06-25 feat: adds display circuit
    [peripherals2.kicad_sch]
2025-06-25 feat: adds button footprints in peripherals sheet
    [peripherals1.kicad_sch]
2025-06-25 feat: adds pin headers
    [microcontroller.kicad_sch, peripherals1.kicad_sch, power_supply.kicad_sch]
2025-06-25 feat: connects SPI and I2C pins to MCU
    [microcontroller.kicad_sch, peripherals2.kicad_sch, power_supply.kicad_sch]
2025-06-26 feat: adds footprints and new light sensor
    [microcontroller.kicad_sch, peripherals1.kicad_sch, peripherals2.kicad_sch, power_supply.kicad_sch, untitled.kicad_sch]
2025-06-26 feat: connects all global labels
    [microcontroller.kicad_sch, peripherals1.kicad_sch, peripherals2.kicad_sch, power_supply.kicad_sch]
2025-06-26 chore: makes changes for DRC check compliance
    [microcontroller.kicad_sch, peripherals1.kicad_sch, peripherals2.kicad_sch, power_supply.kicad_sch]
2025-06-26 chore: updates PCB from schematic
    [zbook.kicad_pcb]
2025-06-26 feat: adds testpoints
    [microcontroller.kicad_sch, peripherals1.kicad_sch, peripherals2.kicad_sch, power_supply.kicad_sch, zbook.kicad_pcb]
2025-06-26 wip: moves components around on PCB
    [microcontroller.kicad_sch, zbook.kicad_pcb]
2025-06-26 chore: adds 3d missing from LED footprint
2025-06-28 feat: adds requested components
    [microcontroller.kicad_sch, peripherals1.kicad_sch, peripherals2.kicad_sch, zbook.kicad_pcb, zbook.kicad_sch]
2025-06-28 chore: resets PCB and adds constraints
    [zbook.kicad_pcb]
2025-06-29 wip: microcontroller placement
    [zbook.kicad_pcb]
2025-06-29 feat: started power supply placement
    [zbook.kicad_pcb]
2025-06-30 wip: places rp circuitry
    [microcontroller.kicad_sch, zbook.kicad_pcb]
2025-06-30 wip: places more rp circuitry
    [zbook.kicad_pcb]
2025-06-30 fix: changes external header to socket
    [microcontroller.kicad_sch]
2025-07-01 feat: adds pull-up resistors to wi-fi header
    [microcontroller.kicad_sch, zbook.kicad_pcb]
2025-07-01 feat:adds peripherals1 placement
    [zbook.kicad_pcb]
2025-07-01 feat: adds the placement of peripherals-2 to the board
    [zbook.kicad_pcb]
2025-07-02 refac: changes peripherals2 placement a bit
    [microcontroller.kicad_sch, peripherals2.kicad_sch, zbook.kicad_pcb]
2025-07-02 Revert "refac: changes peripherals2 placement a bit"
    This reverts commit 93e1f0bf6a0797c7dbeceb6b97671e5315e8a9c5.
    [microcontroller.kicad_sch, peripherals2.kicad_sch, zbook.kicad_pcb]
2025-07-02 Revert "feat: adds the placement of peripherals-2 to the board"
    This reverts commit b3199939d124e574fadd2f4218b059d7ba05c286.
    [zbook.kicad_pcb]
2025-07-02 feat: places power circuitry with microcontroller
    [power_supply.kicad_sch, zbook.kicad_pcb]
2025-07-02 chore: updates display capacitors
    [microcontroller.kicad_sch, peripherals2.kicad_sch, zbook.kicad_pcb]
2025-07-03 wip: placement
    [microcontroller.kicad_sch, peripherals1.kicad_sch, zbook.kicad_pcb]
2025-07-03 feat: finishes first iteration of placement
    [zbook.kicad_pcb]
2025-07-03 feat: adds GND planes to L2 and L3
    [zbook.kicad_pcb]
2025-07-04 feat: starts routing
    [microcontroller.kicad_sch, peripherals1.kicad_sch, power_supply.kicad_sch, zbook.kicad_pcb]
2025-07-25 wip: adds more routing
    [microcontroller.kicad_sch, peripherals1.kicad_sch, peripherals2.kicad_sch, power_supply.kicad_sch, zbook.kicad_pcb]
2025-08-12 feat: finishes p1 routing
    [microcontroller.kicad_sch, zbook.kicad_pcb]
2025-08-12 refac: changes IR emitter
    [peripherals1.kicad_sch, zbook.kicad_pcb]
2025-08-12 fix: moves microphone silkscreen designator
    [zbook.kicad_pcb]
2025-09-24 chore: updates some parameters in components
    [microcontroller.kicad_sch, peripherals1.kicad_sch, peripherals2.kicad_sch, power_supply.kicad_sch, zbook.kicad_pcb, zbook.kicad_sch]
2025-09-24 feat: adds more stitching vias
    [zbook.kicad_pcb]
2025-09-29 fix: fixes schematic errors and some layout errors
    [microcontroller.kicad_sch, peripherals1.kicad_sch, power_supply.kicad_sch, zbook.kicad_pcb]
2025-09-30 fix: changes phototransistor footprint
    [peripherals1.kicad_sch, zbook.kicad_pcb]
2025-09-30 fix: fixes header table behind pcb
    [zbook.kicad_pcb]
2025-10-01 refac: adds one more via for shielding an analog trace
    [zbook.kicad_pcb]
2025-10-01 refac: aligns all buttons
    [microcontroller.kicad_sch, peripherals2.kicad_sch, zbook.kicad_pcb]
2025-10-02 fix: moves designator away from exposed copper
    [zbook.kicad_pcb]
2025-10-07 fix: fixes DVDD tied to +3V3 instead of +1V1
    [microcontroller.kicad_sch, zbook.kicad_pcb]
2025-10-13 chore: adds labels to GPIO header
    [peripherals1.kicad_sch, zbook.kicad_pcb]
2025-10-13 chore: adds ESP01 3D model to footprint
    [zbook.kicad_pcb]
2025-10-15 chore: adds display model to footprint
    [zbook.kicad_pcb]
2025-10-15 chore: unfits wifi pull-ups
    [microcontroller.kicad_sch]
2025-10-16 refac: moves display up
    [zbook.kicad_pcb]
2025-10-16 refac: moves accelerometer
    [zbook.kicad_pcb]
2025-10-16 refac: changes OR circuit in power supply
    [microcontroller.kicad_sch, peripherals1.kicad_sch, peripherals2.kicad_sch, power_supply.kicad_sch, zbook.kicad_pcb]
2025-10-21 fix: fixes fiducials and mouting holes
    [zbook.kicad_pcb, zbook.kicad_sch]
2025-10-28 feat: adds additional mounting hole
    [zbook.kicad_pcb, zbook.kicad_sch]
2025-11-12 chore: last modifications before manufacturing
    [zbook.kicad_pcb]
2026-01-20 chore: generates 3D files
    [zbook.kicad_pcb, zbook.step]
2026-02-26 feat: adds 4th wire to display, removes remaining sdcard lines
    [microcontroller.kicad_sch, peripherals1.kicad_sch, peripherals2.kicad_sch, power_supply.kicad_sch, zbook.kicad_pcb]
2026-02-26 fix: removes solder past layer from display conn
    [peripherals2.kicad_sch, zbook.kicad_pcb]
